MaikeM/CocktailPi/short_presentation.pdf

# Interactive Bar

Affective Lighting - SS 15 by Nicolas Erbach, Tobias Kiefer, Maike Maas und Manuel Zapp

# What we did so far

- Built the rack of the bar except for the shelves

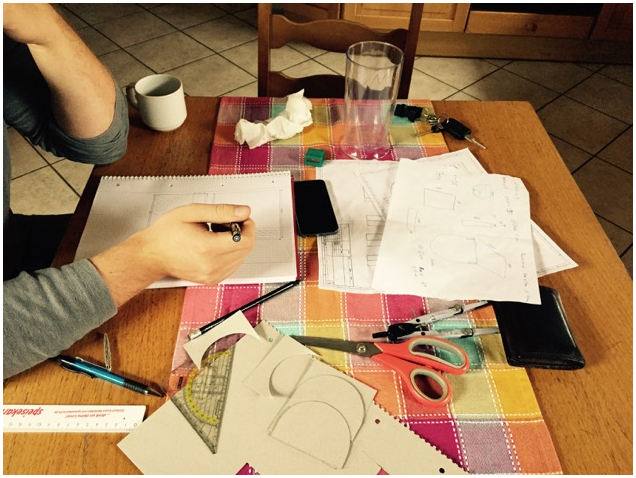
[picture p19: figure]

# What we did so far

- Built the rack of the bar except for the shelves

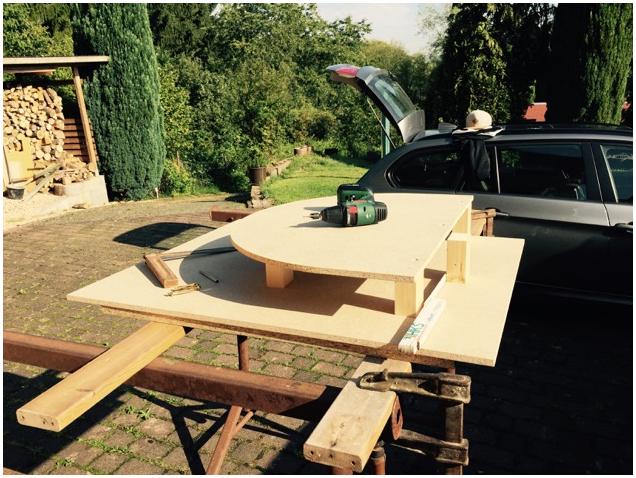
[picture p20: figure]

# What we did so far

- Built the rack of the bar except for the shelves

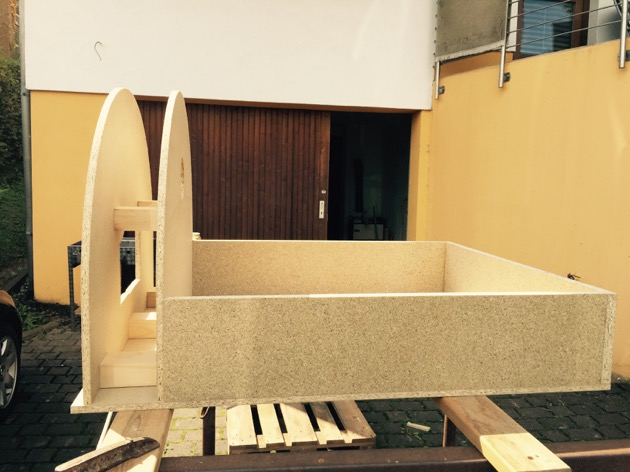
[picture p21: figure]

# What we did so far

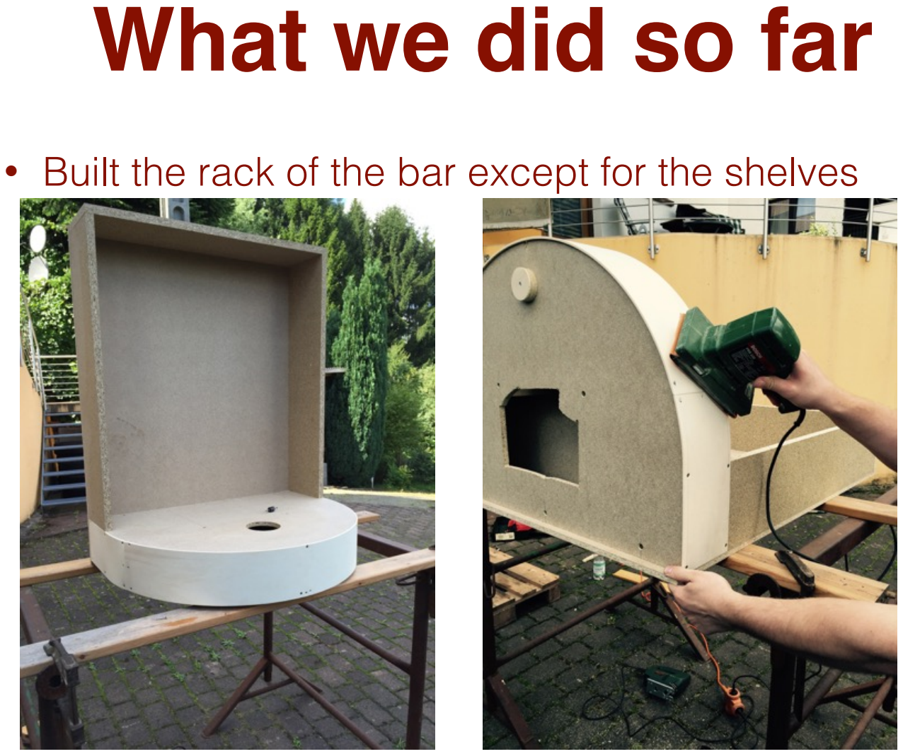
[picture p22: page 5]

- Built the rack of the bar except for the shelves

# What we did so far

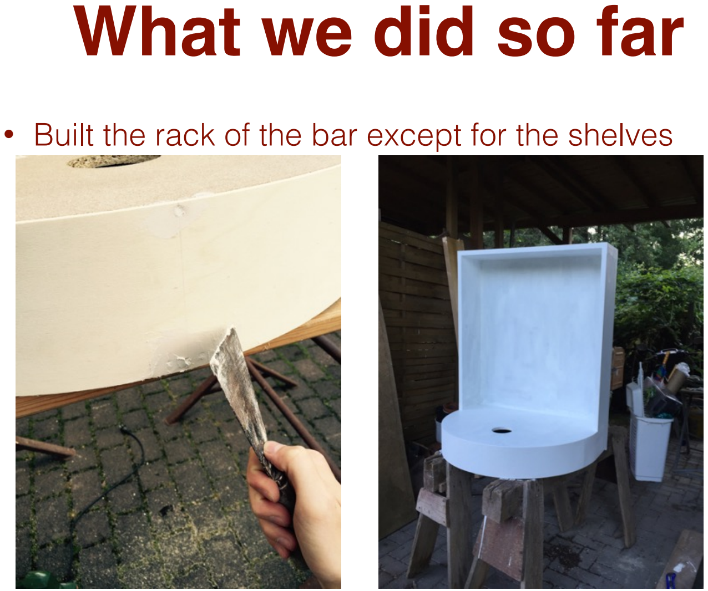
[picture p23: page 6]

- Built the rack of the bar except for the shelves

# What we did so far

- Implemented the database with the cocktails

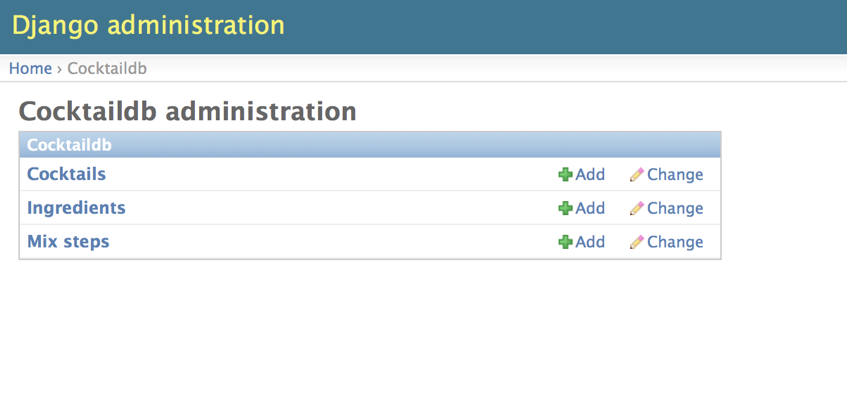
[picture p24: figure]

# What we did so far

- Implemented the database with the cocktails

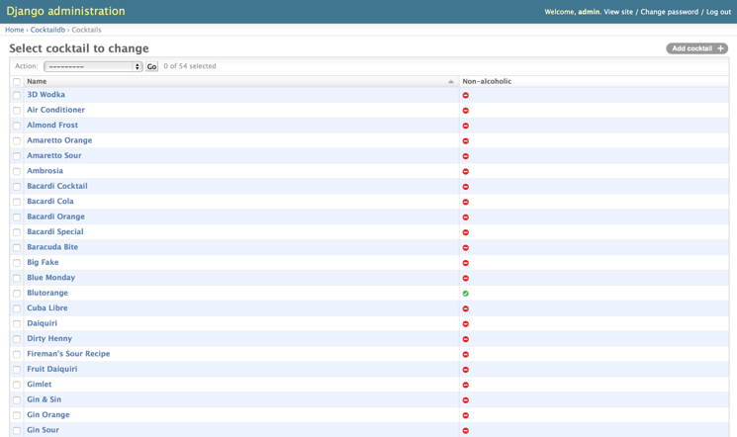
[picture p25: figure]

# What we did so far

- Implemented the database with the cocktails

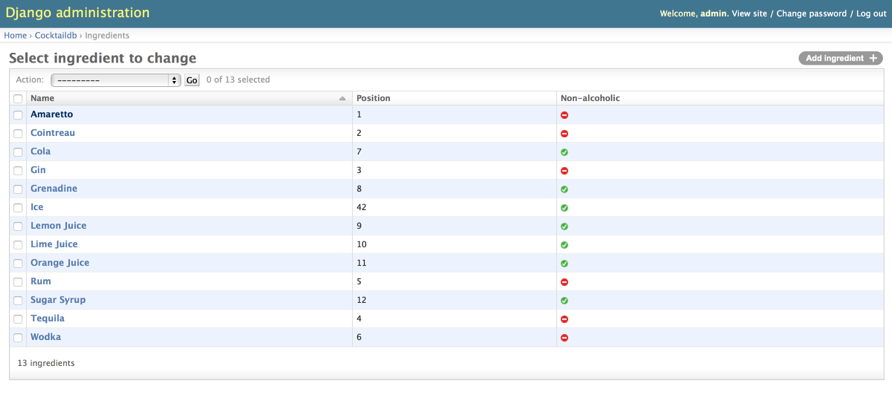
[picture p26: figure]

# What we did so far

- Implemented the database with the cocktails

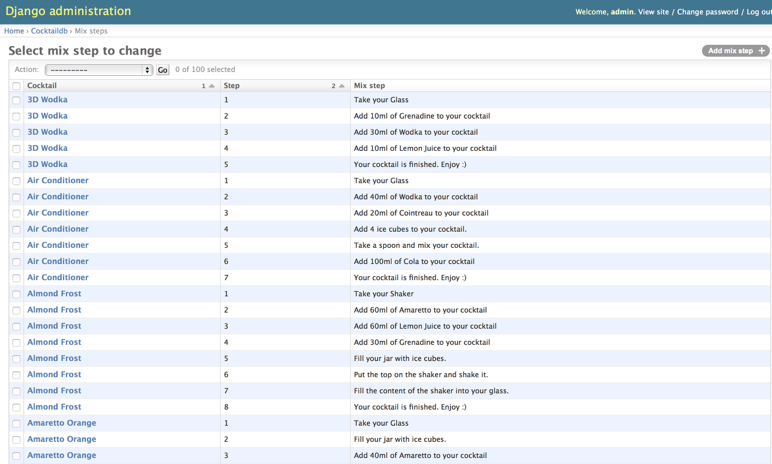
[picture p27: figure]

# What we did so far

- Implemented the website

# What we did so far

- Set up the Access Point on the raspberry

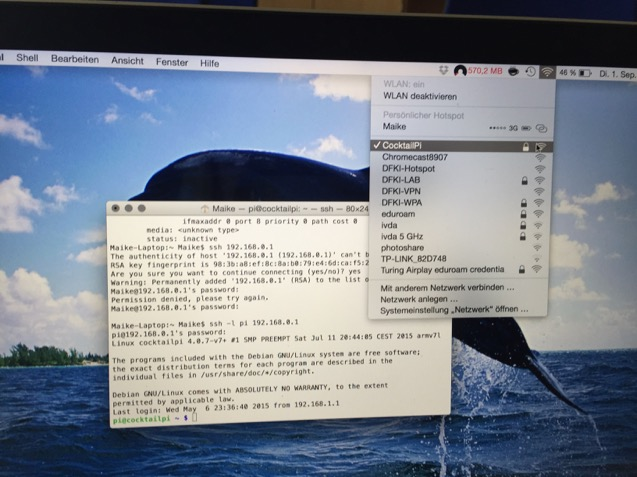
[picture p28: figure]

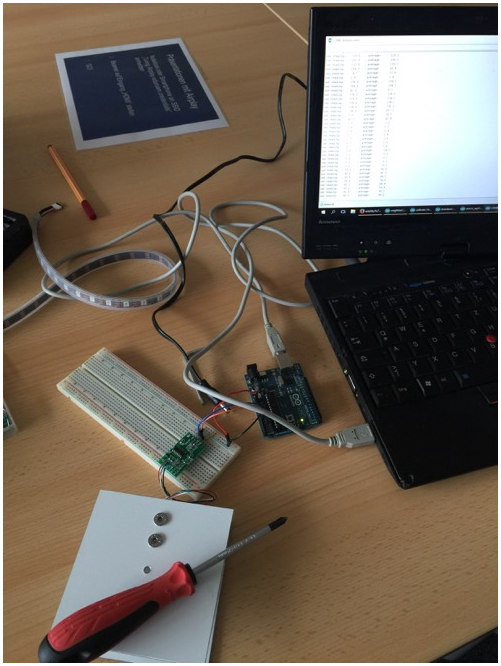
[picture p29: figure]

# What we did so far

- Tested the weight
measuring module

# What we did so far

- Control the light strip with the Arduino

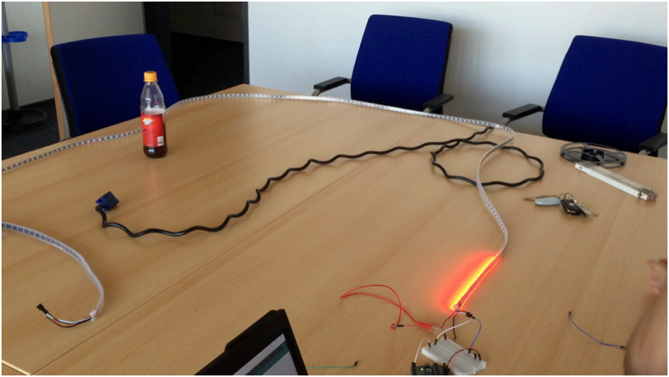
[picture p30: figure]

# What we changed

- Changed the look of the shelves

# Next steps

- Painting and finishing the rack
- Implement the complete controlling of the Raspberry and the Arduino
- Install the light strips at the rack
- Test the bar ;)
