MaikeM/CocktailPi/Documentation/pictures/arduino_mit_kabel.JPG

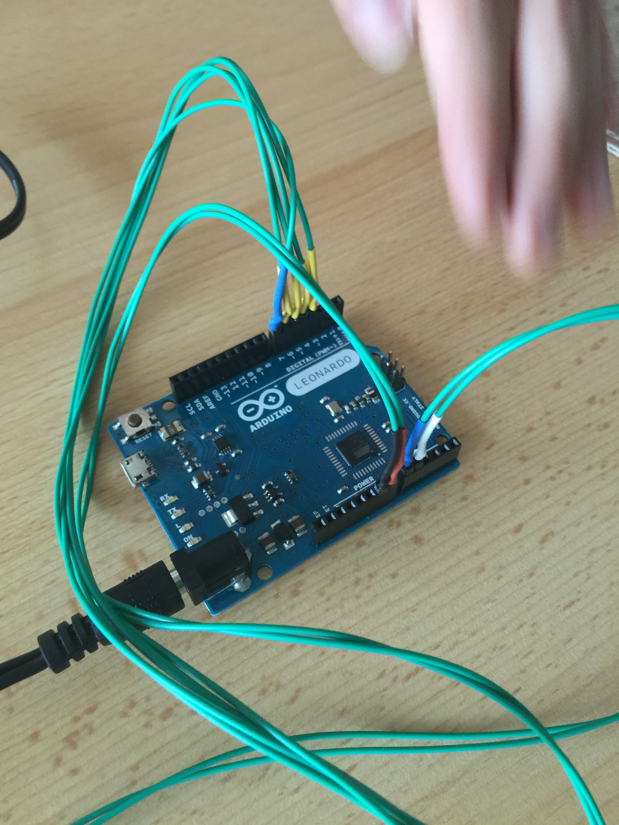
Documentation/pictures/arduino_mit_kabel.JPG
