MaikeM/CocktailPi/Documentation/pictures/bar2.jpg

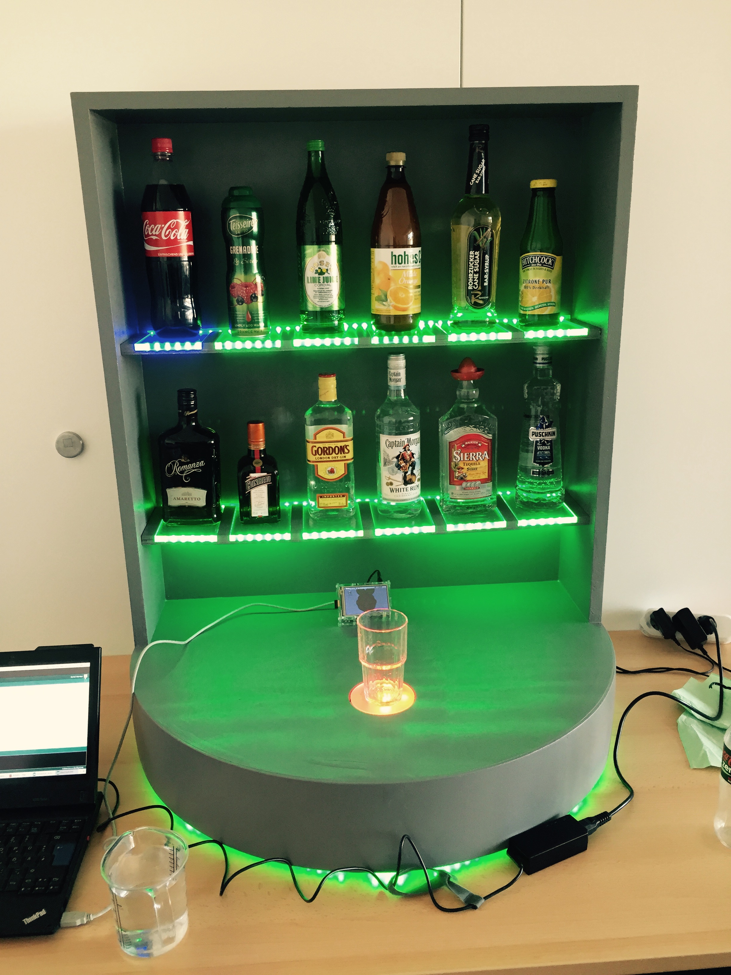
Documentation/pictures/bar2.jpg
