MaikeM/CocktailPi/Documentation/pictures/polieren.jpg

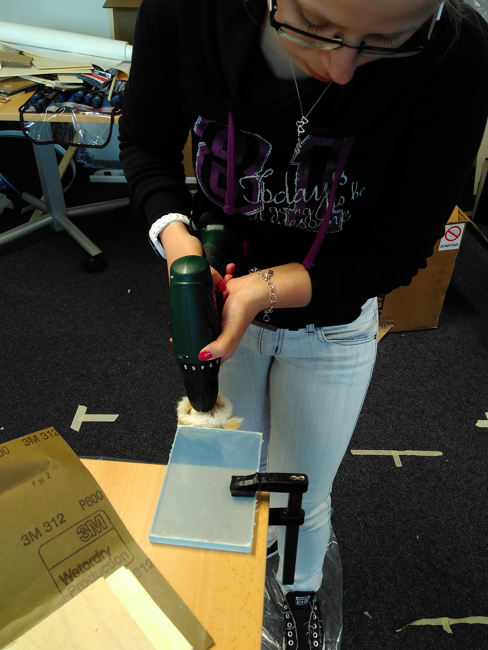
Documentation/pictures/polieren.jpg
