MaikeM/CocktailPi/Documentation/pictures/schleifen.jpg

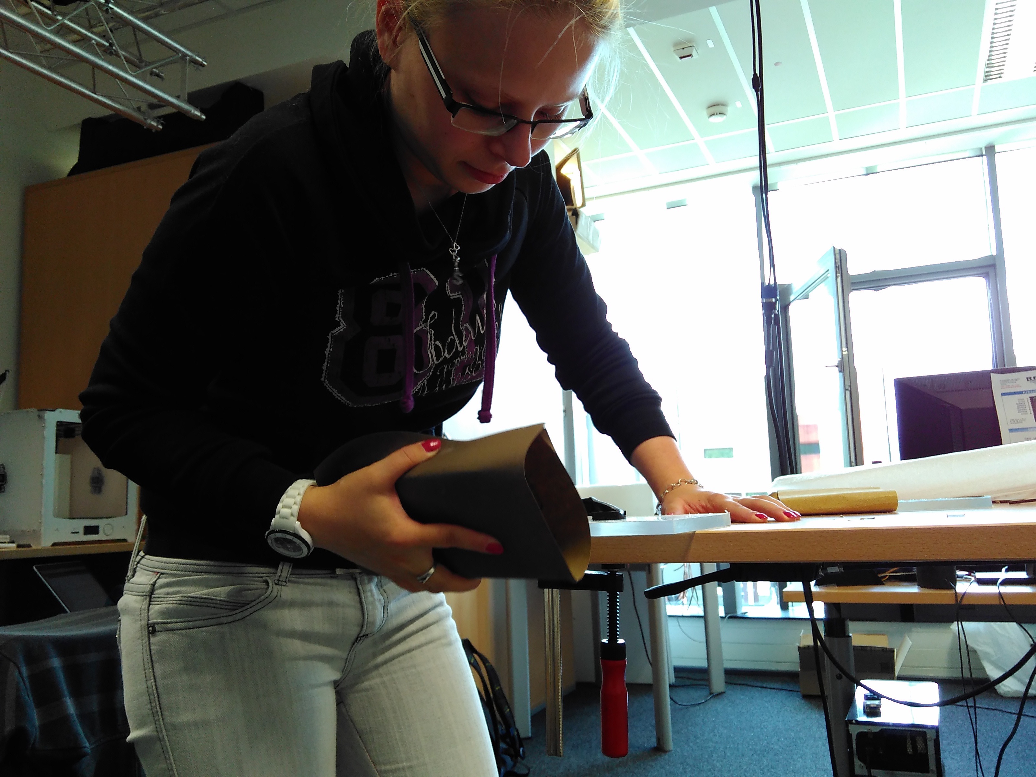
Documentation/pictures/schleifen.jpg
