MaikeM/CocktailPi/Documentation/pictures/sketch.pdf

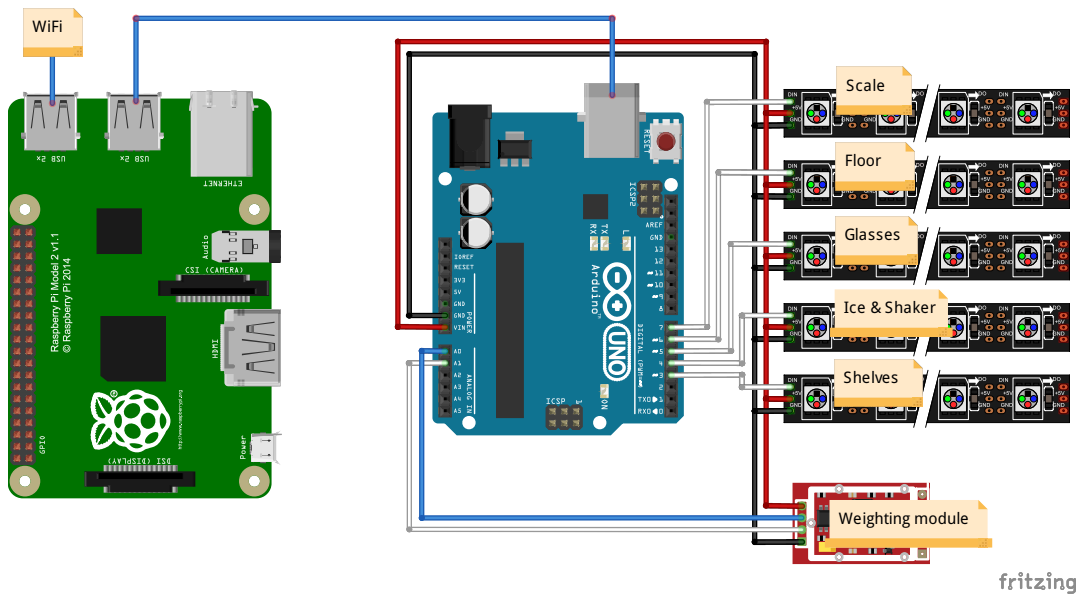
[picture p51: page 1]
WiFi; ale; Flo; Gla; elve; eig; h tin; ule
