MaikeM/CocktailPi/(list of files, drawings)

Other design files:
Fritzing/Sketch for tex.fzz
