MaikeM/CocktailPi/cocktail/cocktaildb/urls.py

from django.conf.urls import url
from . import views
urlpatterns = [
    url(r'^$', views.index, name='index'),
    #url(r'^filter/(?P<cocktail>[0-9]+)/(?P<ingredient>[0-9]+)/(?P<alc>[0-9]+)/', views.filter, name='filter'),
    #url(r'^cocktail/(?P<cocktail_id>[0-9]+)/(?P<step>[0-9]+)/', views.cocktail, name='cocktail'),
    url(r'^cocktailcontent/', views.pidisplay, name='pidisplay'),
    url(r'^cocktail/', views.pidisplayframe, name='pidisplayframe'),
    url(r'^ingredient/(?P<ingredient_id>[0-9]+)/', views.ingredient, name='ingredient'),
    url(r'^ingredients/', views.ingredients, name='ingredients'),
    url(r'^mix/(?P<cocktail_id>[0-9]+)/', views.mix, name='mix'),
    url(r'^boot/(?P<mode_id>[0-9]+)/', views.boot, name='boot'),
]
