MaikeM/CocktailPi/(commit log)

2015-09-03 Zutaten und Step Liste
2015-09-07 arduino testsketch
2015-09-07 Raspberry communication
2015-09-09 Leds beachten Gewicht.
2015-09-10 Arduino und Teile vom Filter
2015-09-11 Aussehen der Steps verändert
2015-09-21 First version of soldering and wiring added
2015-09-21 Fritzing skecth included and inserted into tex.
    [Sketch for tex.fzz]
2015-09-23 Added text for Webserver, Arduino and Raspberry. Moved text for protocol to Communication Protocoll.
2015-09-23 Bilder von Arduino und Raspberry
2015-09-23 pic of raspberry
